carnegie-mellon-rocket-command/avionics-hw27-pelican/pelican.step

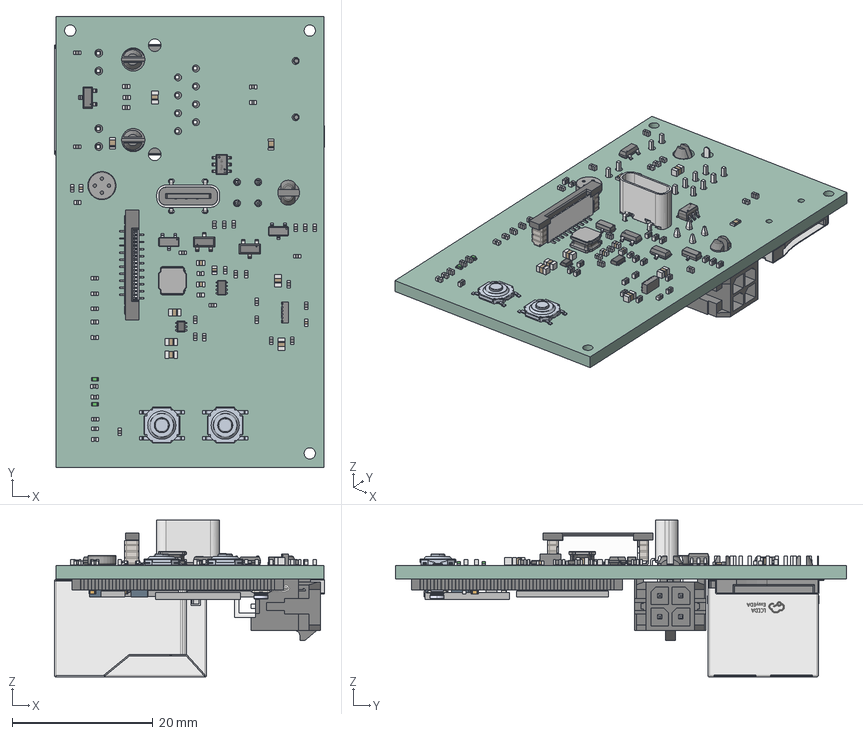
[picture p1: CAD file, 2026-10-25]
pelican.step
38.3 x 64.0 x 22.3 mm
IND-SMD_L4.0-W4.0-H1.9
RGT16
BODY-SOT x 2
CUI_CMC-4013-SMT
LED0402-RD_GREEN x 2
DMG2305UX-13 x 2
FPC-SMD_20P-P0.50_HDGC_0.5K-A-20PB
SOT-23-6_L2.9-W1.6-H1.5-LS2.8-P0.95
TYPE-C-SMD_USB4120-03-C
FRAME-DRL0006A
PIN1-ID
TF-SMD_TF-115-BCP9
OPEN_CASCADE_STEP_TRANSLATOR_7_
EXTRUDED-9461
USER_LIBRARY-U_FL-R-SMT_10_
USER_LIBRARY-0201_0603M__CAP_1 x 37
USER_LIBRARY-0201_0603M__CAP_2 x 37
USER_LIBRARY-0201_0603M__CAP_3 x 37
3_1_A x 32
SOD323
5_1_2_A x 11
_7_AF0 x 11
EXTRUDED-47948 x 3
USER_LIBRARY-RES_0603-0201_1 x 45
USER_LIBRARY-RES_0603-0201_2 x 45
USER_LIBRARY-RES_0603-0201_3 x 45
USER_LIBRARY-RES_0603-0201_4 x 45
EXTRUDED-53873
EXTRUDED-54088
EXTRUDED-54303
EXTRUDED-54518
EXTRUDED-54737
EXTRUDED-54962
RJ45-TH_HR911105A
pelican_PCB
