carnegie-mellon-rocket-command/avionics-hw27-pelican/pelican.kicad_pcb

## KiCad design pelican.kicad_pcb (2026-10-16)

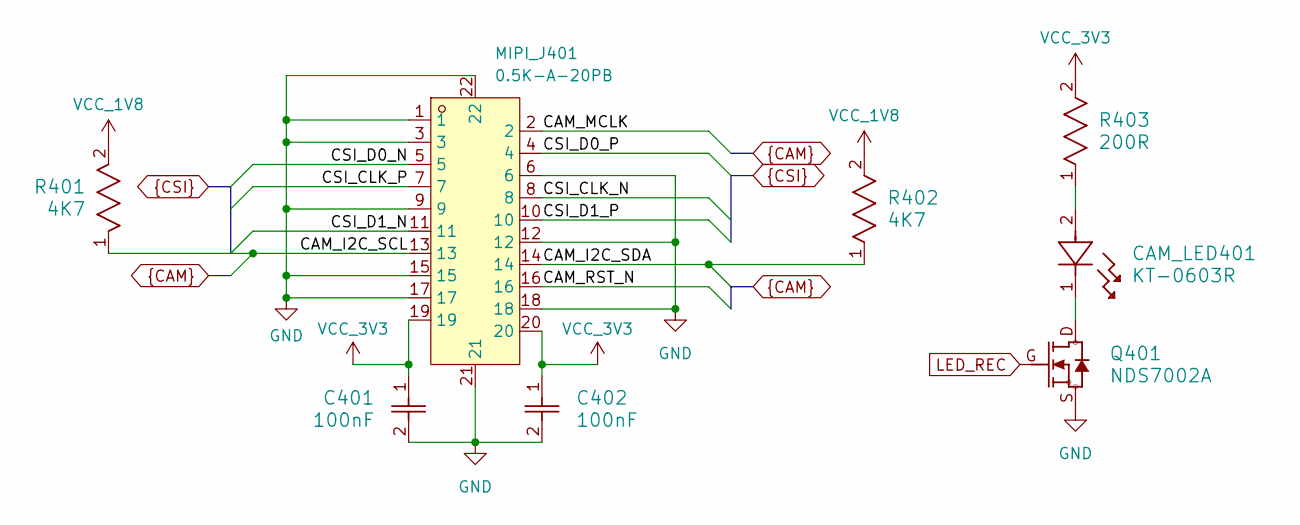
[picture p2: schematic camera_pelican.kicad_sch, Pelican]

Parts:
C401, C402: 100nF; C_GRM155R71C104KA88D; LCSC Part # C1525
CAM_LED401: KT-0603R; LED_LTST-C193KRKT-5A; LCSC Part # C2286
MIPI_J401: 0.5K-A-20PB; J_0.5K-A-20PB; MPN 0.5K-A-20PB; LCSC Part C2914144
Q401: NDS7002A; Q_NDS7002A; LCSC Part # C74715
R401, R402: 4K7; R_RC0402FR; LCSC Part # C25900
R403: 200R; R_RC0402FR; LCSC Part # C25087

Connections:
CAM_I2C_SCL: MIPI_J401.13, R401.1; also elsewhere on the board
CAM_I2C_SDA: MIPI_J401.14, R402.1; also elsewhere on the board
CAM_MCLK: MIPI_J401.2; also elsewhere on the board
CAM_RST_N: MIPI_J401.16; also elsewhere on the board
CSI_CLK_N: MIPI_J401.8; also elsewhere on the board
CSI_CLK_P: MIPI_J401.7; also elsewhere on the board
CSI_D0_N: MIPI_J401.5; also elsewhere on the board
CSI_D0_P: MIPI_J401.4; also elsewhere on the board
CSI_D1_N: MIPI_J401.11; also elsewhere on the board
CSI_D1_P: MIPI_J401.10; also elsewhere on the board
GND: C401.2, C402.2, MIPI_J401.1, MIPI_J401.3, MIPI_J401.6, MIPI_J401.9, MIPI_J401.12, MIPI_J401.15, MIPI_J401.17, MIPI_J401.18, MIPI_J401.21, MIPI_J401.22, Q401.S; also elsewhere on the board
LED_REC: Q401.G; also elsewhere on the board
unnamed: CAM_LED401.1, Q401.D
unnamed: CAM_LED401.2, R403.1
VCC_1V8: R401.2, R402.2; also elsewhere on the board
VCC_3V3: C401.1, C402.1, MIPI_J401.19, MIPI_J401.20, R403.2; also elsewhere on the board

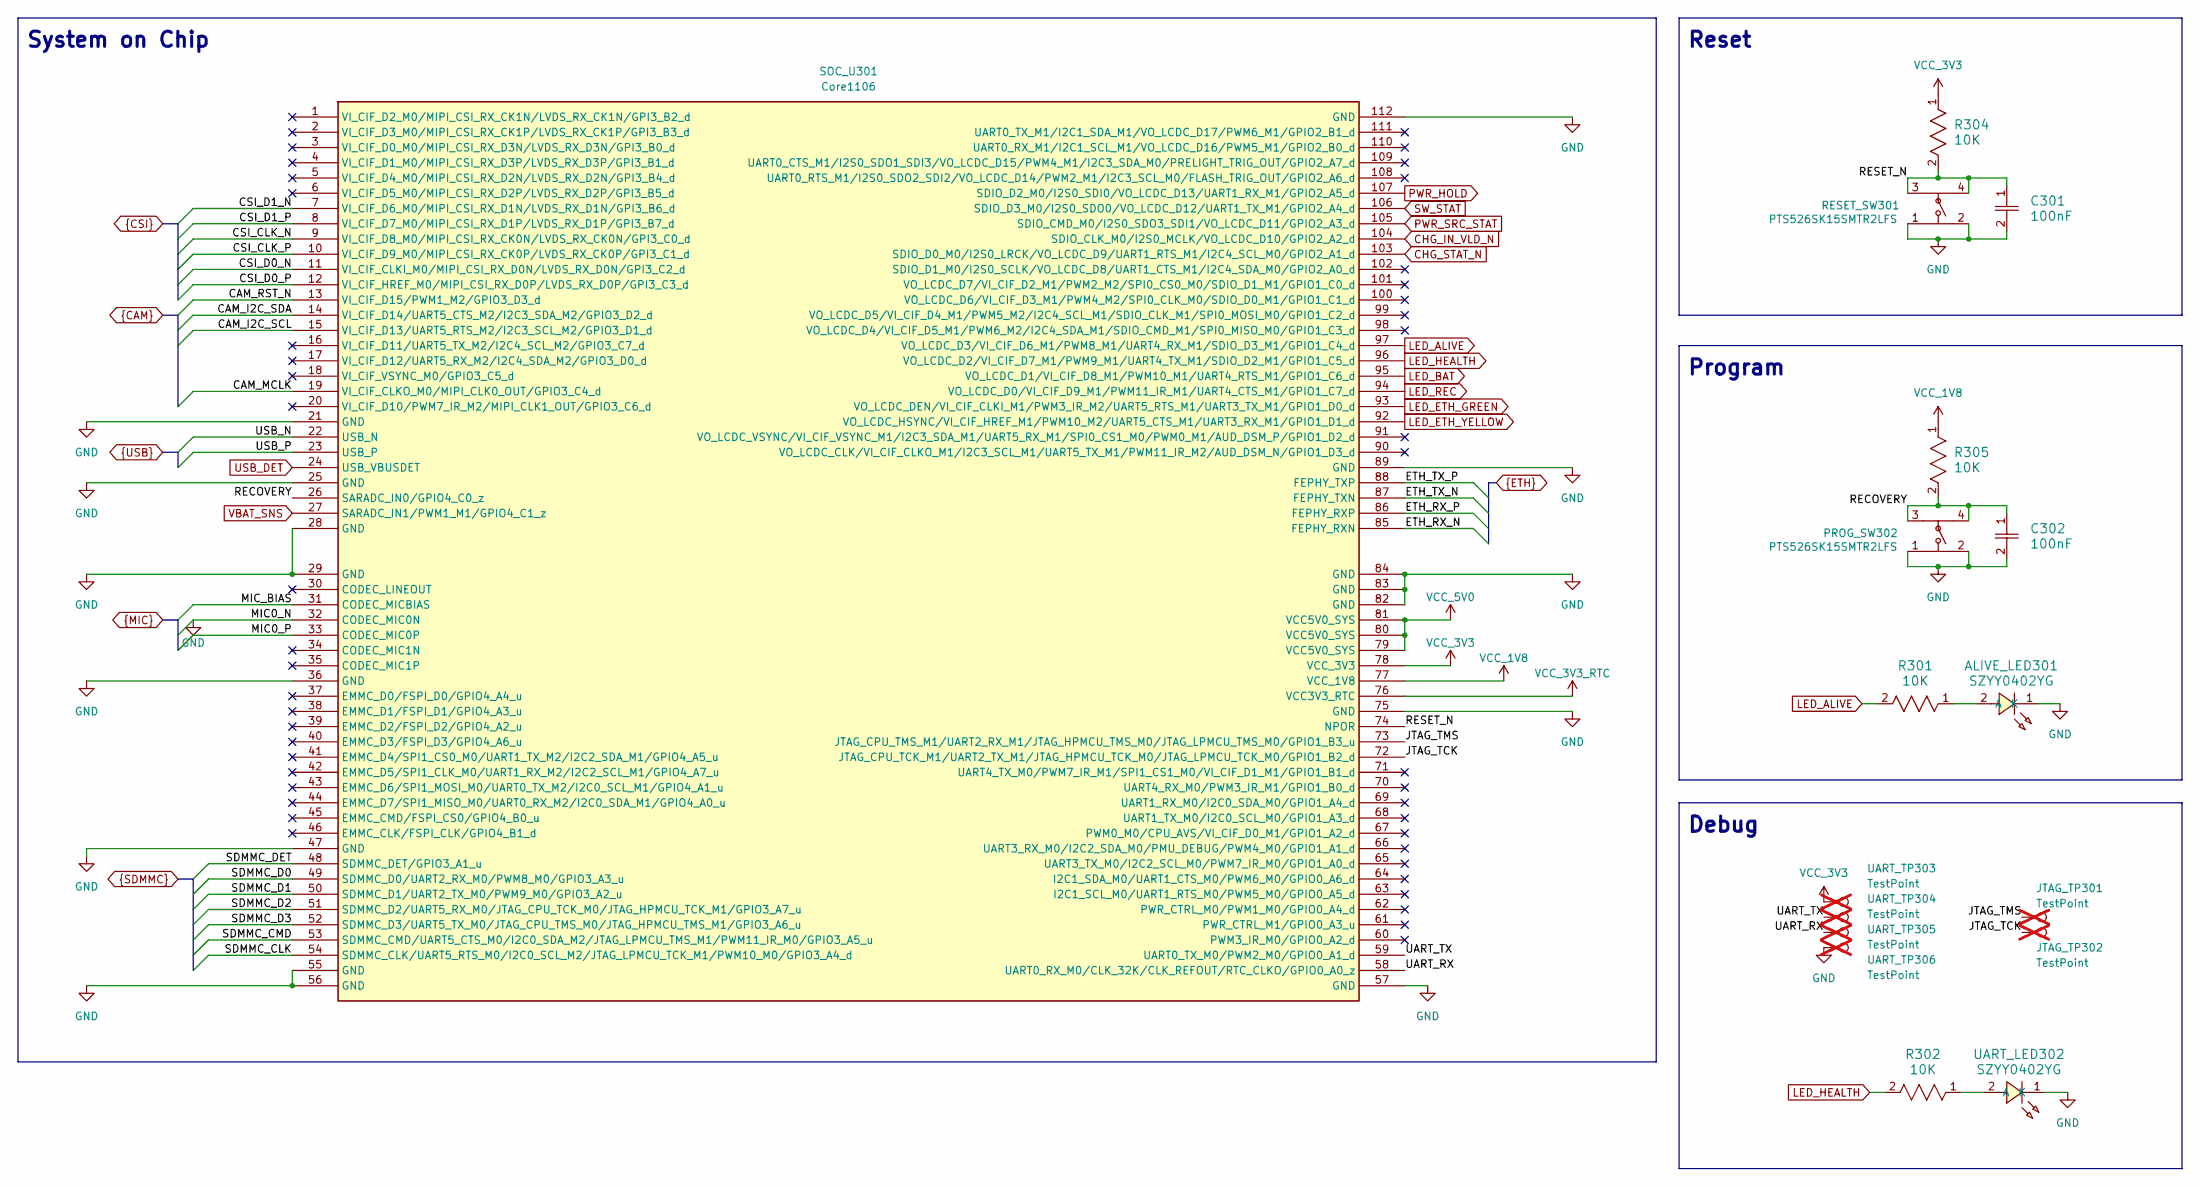
[picture p3: schematic core_pelican.kicad_sch, Pelican]

Parts:
ALIVE_LED301: SZYY0402YG; LED_SZYY0402YG; MPN SZYY0402YG; LCSC Part # C434449
C301, C302: 100nF; C_GRM155R71C104KA88D; LCSC Part # C1525
JTAG_TP301, JTAG_TP302: TestPoint; TestPoint_Pad_D1.5mm; not fitted
PROG_SW302: PTS526SK15SMTR2LFS; SW_PTS526SK15SMTR2LFS; LCSC Part # C2689521
R301, R302, R304, R305: 10K; R_RC0402FR; LCSC Part # C25744
RESET_SW301: PTS526SK15SMTR2LFS; SW_PTS526SK15SMTR2LFS; LCSC Part # C2689521
SOC_U301: Core1106; P_Core1106
UART_LED302: SZYY0402YG; LED_SZYY0402YG; MPN SZYY0402YG; LCSC Part # C434449
UART_TP303, UART_TP304, UART_TP305, UART_TP306: TestPoint; TestPoint_Pad_D1.5mm; not fitted

Connections:
/Core/JTAG_TCK: JTAG_TP302.1 (1_1), SOC_U301.72 (JTAG_CPU_TCK_M1/UART2_TX_M1/JTAG_HPMCU_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)
/Core/JTAG_TMS: JTAG_TP301.1 (1_1), SOC_U301.73 (JTAG_CPU_TMS_M1/UART2_RX_M1/JTAG_HPMCU_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)
/Core/RECOVERY: C302.1, PROG_SW302.3, PROG_SW302.4, R305.2, SOC_U301.26 (SARADC_IN0/GPIO4_C0_z)
/Core/RESET_N: C301.1, R304.2, RESET_SW301.3, RESET_SW301.4, SOC_U301.74 (NPOR)
/Core/UART_RX: SOC_U301.58 (UART0_RX_M0/CLK_32K/CLK_REFOUT/RTC_CLKO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), UART_TP305.1 (1_1)
/Core/UART_TX: SOC_U301.59 (UART0_TX_M0/PWM2_M0/GPIO0_A1_d), UART_TP304.1 (1_1)
CAM_I2C_SCL: SOC_U301.15 (VI_CIF_D13/UART5_RTS_M2/I2C3_SCL_M2/GPI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); also elsewhere on the board
CAM_I2C_SDA: SOC_U301.14 (VI_CIF_D14/UART5_CTS_M2/I2C3_SDA_M2/GPI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); also elsewhere on the board
CAM_MCLK: SOC_U301.19 (VI_CIF_CLKO_M0/MIPI_CLK0_OUT/GPIO3_C4_d); also elsewhere on the board
CAM_RST_N: SOC_U301.13 (VI_CIF_D15/PWM1_M2/GPIO3_D3_d); also elsewhere on the board
CHG_IN_VLD_N: SOC_U301.104 (SDIO_CLK_M0/I2S0_MCLK/VO_LCDC_D10/GPIO2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); also elsewhere on the board
CHG_STAT_N: SOC_U301.103 (SDIO_D0_M0/I2S0_LRCK/VO_LCDC_D9/UART1_R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); also elsewhere on the board
CSI_CLK_N: SOC_U301.9 (VI_CIF_D8_M0/MIPI_CSI_RX_CK0N/LVDS_RX_C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); also elsewhere on the board
CSI_CLK_P: SOC_U301.10 (VI_CIF_D9_M0/MIPI_CSI_RX_CK0P/LVDS_RX_C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); also elsewhere on the board
CSI_D0_N: SOC_U301.11 (VI_CIF_CLKI_M0/MIPI_CSI_RX_D0N/LVDS_RX_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); also elsewhere on the board
CSI_D0_P: SOC_U301.12 (VI_CIF_HREF_M0/MIPI_CSI_RX_D0P/LVDS_RX_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); also elsewhere on the board
CSI_D1_N: SOC_U301.7 (VI_CIF_D6_M0/MIPI_CSI_RX_D1N/LVDS_RX_D1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); also elsewhere on the board
CSI_D1_P: SOC_U301.8 (VI_CIF_D7_M0/MIPI_CSI_RX_D1P/LVDS_RX_D1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); also elsewhere on the board
ETH_RX_N: SOC_U301.85 (FEPHY_RXN); also elsewhere on the board
ETH_RX_P: SOC_U301.86 (FEPHY_RXP); also elsewhere on the board
ETH_TX_N: SOC_U301.87 (FEPHY_TXN); also elsewhere on the board
ETH_TX_P: SOC_U301.88 (FEPHY_TXP); also elsewhere on the board
GND: ALIVE_LED301.1 (K), C301.2, C302.2, PROG_SW302.1, PROG_SW302.2, RESET_SW301.1, RESET_SW301.2, SOC_U301.21 (GND), SOC_U301.25 (GND), SOC_U301.28 (GND), SOC_U301.29 (GND), SOC_U301.32 (CODEC_MIC0N), SOC_U301.36 (GND), SOC_U301.47 (GND), SOC_U301.55 (GND), SOC_U301.56 (GND), SOC_U301.57 (GND), SOC_U301.75 (GND), SOC_U301.82 (GND), SOC_U301.83 (GND), SOC_U301.84 (GND), SOC_U301.89 (GND), SOC_U301.112 (GND), UART_LED302.1 (K), UART_TP306.1 (1_1); also elsewhere on the board
LED_ALIVE: R301.2, SOC_U301.97 (VO_LCDC_D3/VI_CIF_D6_M1/PWM8_M1/UART4_R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)
LED_BAT: SOC_U301.95 (VO_LCDC_D1/VI_CIF_D8_M1/PWM10_M1/UART4_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); also elsewhere on the board
LED_ETH_GREEN: SOC_U301.93 (VO_LCDC_DEN/VI_CIF_CLKI_M1/PWM3_IR_M2/U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); also elsewhere on the board
LED_ETH_YELLOW: SOC_U301.92 (VO_LCDC_HSYNC/VI_CIF_HREF_M1/PWM10_M2/U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); also elsewhere on the board
LED_HEALTH: R302.2, SOC_U301.96 (VO_LCDC_D2/VI_CIF_D7_M1/PWM9_M1/UART4_T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)
LED_REC: SOC_U301.94 (VO_LCDC_D0/VI_CIF_D9_M1/PWM11_IR_M1/UAR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); also elsewhere on the board
MIC0_P: SOC_U301.33 (CODEC_MIC0P); also elsewhere on the board
MIC_BIAS: SOC_U301.31 (CODEC_MICBIAS); also elsewhere on the board
unnamed: ALIVE_LED301.2 (A), R301.1
unnamed: R302.1, UART_LED302.2 (A)
PWR_HOLD: SOC_U301.107 (SDIO_D2_M0/I2S0_SDI0/VO_LCDC_D13/UART1_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); also elsewhere on the board
PWR_SRC_STAT: SOC_U301.105 (SDIO_CMD_M0/I2S0_SDO3_SDI1/VO_LCDC_D11/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); also elsewhere on the board
SDMMC_CLK: SOC_U301.54 (SDMMC_CLK/UART5_RTS_M0/I2C0_SCL_M2/JTAG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); also elsewhere on the board
SDMMC_CMD: SOC_U301.53 (SDMMC_CMD/UART5_CTS_M0/I2C0_SDA_M2/JTAG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); also elsewhere on the board
SDMMC_D0: SOC_U301.49 (SDMMC_D0/UART2_RX_M0/PWM8_M0/GPIO3_A3_u); also elsewhere on the board
SDMMC_D1: SOC_U301.50 (SDMMC_D1/UART2_TX_M0/PWM9_M0/GPIO3_A2_u); also elsewhere on the board
SDMMC_D2: SOC_U301.51 (SDMMC_D2/UART5_RX_M0/JTAG_CPU_TCK_M0/JT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); also elsewhere on the board
SDMMC_D3: SOC_U301.52 (SDMMC_D3/UART5_TX_M0/JTAG_CPU_TMS_M0/JT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); also elsewhere on the board
SDMMC_DET: SOC_U301.48 (SDMMC_DET/GPIO3_A1_u); also elsewhere on the board
SW_STAT: SOC_U301.106 (SDIO_D3_M0/I2S0_SDO0/VO_LCDC_D12/UART1_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); also elsewhere on the board
USB_DET: SOC_U301.24 (USB_VBUSDET); also elsewhere on the board
USB_N: SOC_U301.22 (USB_N); also elsewhere on the board
USB_P: SOC_U301.23 (USB_P); also elsewhere on the board
VBAT_SNS: SOC_U301.27 (SARADC_IN1/PWM1_M1/GPIO4_C1_z); also elsewhere on the board
VCC_1V8: R305.1, SOC_U301.77 (VCC_1V8); also elsewhere on the board
VCC_3V3: R304.1, SOC_U301.78 (VCC_3V3), UART_TP303.1 (1_1); also elsewhere on the board
VCC_3V3_RTC: SOC_U301.76 (VCC3V3_RTC)
VCC_5V0: SOC_U301.79 (VCC5V0_SYS), SOC_U301.80 (VCC5V0_SYS), SOC_U301.81 (VCC5V0_SYS); also elsewhere on the board

Notes on the sheet:
Debug
System on Chip
Program
Reset

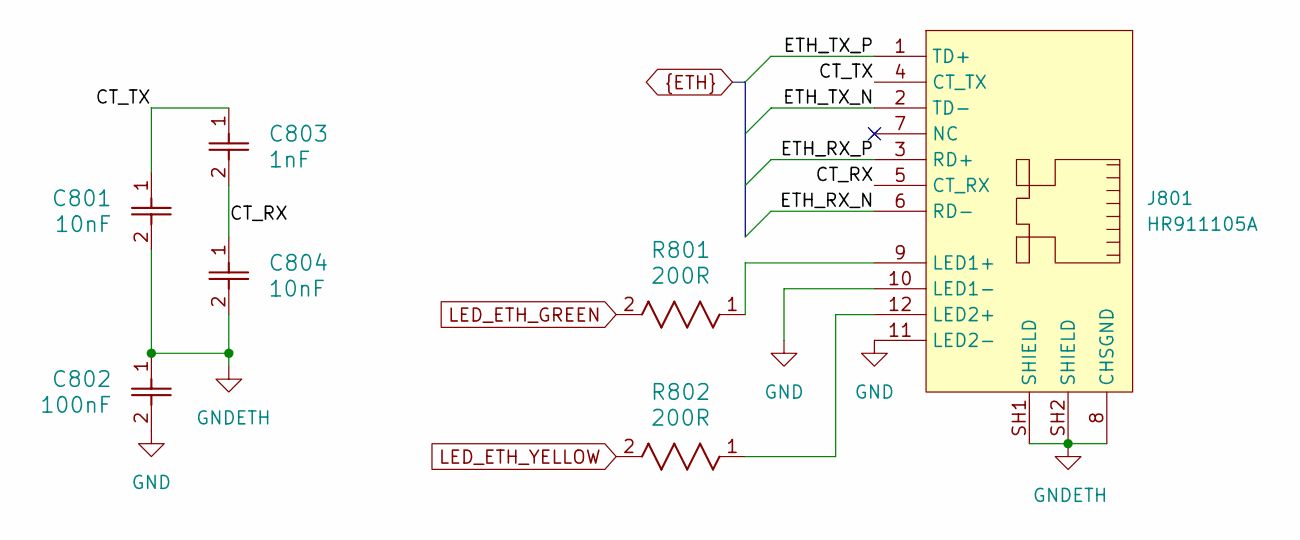
[picture p4: schematic ethernet_pelican.kicad_sch, Pelican]

Parts:
C801, C804: 10nF; C_CL05B103KO5NNNC; MPN CL05B103KO5NNNC; LCSC Part # C15195
C802: 100nF; C_GRM155R71C104KA88D; LCSC Part # C1525
C803: 1nF; C_CC0603CG100V102JN; MPN CC0603CG100V102JN; LCSC Part # C53084479
J801: HR911105A; J_HR911105A_TH; MPN HR911105A; LCSC Part C12074
R801, R802: 200R; R_RC0402FR; LCSC Part # C25087

Connections:
/Ethernet/CT_RX: C803.2, C804.1, J801.5 (CT_RX)
/Ethernet/CT_TX: C801.1, C803.1, J801.4 (CT_TX)
ETH_RX_N: J801.6 (RD-); also elsewhere on the board
ETH_RX_P: J801.3 (RD+); also elsewhere on the board
ETH_TX_N: J801.2 (TD-); also elsewhere on the board
ETH_TX_P: J801.1 (TD+); also elsewhere on the board
GND: C802.2, J801.10 (LED1-), J801.11 (LED2-); also elsewhere on the board
GNDETH: C801.2, C802.1, C804.2, J801.8 (CHSGND), J801.SH1 (SHIELD), J801.SH2 (SHIELD)
LED_ETH_GREEN: R801.2; also elsewhere on the board
LED_ETH_YELLOW: R802.2; also elsewhere on the board
unnamed: J801.9 (LED1+), R801.1
unnamed: J801.12 (LED2+), R802.1

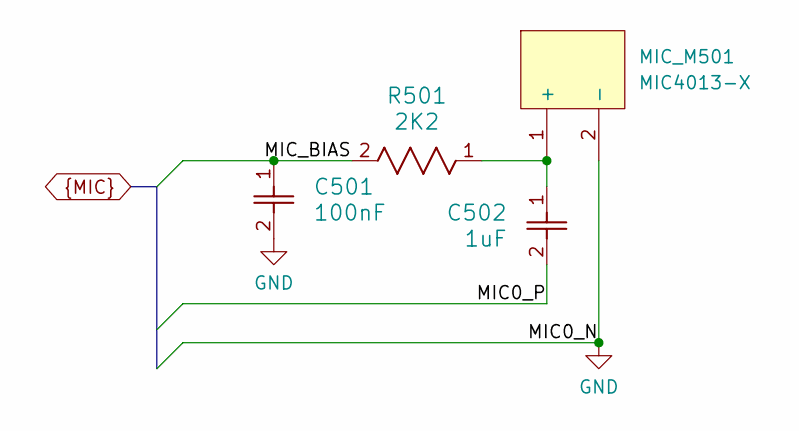
[picture p5: schematic microphone_pelican.kicad_sch, Pelican]

Parts:
C501: 100nF; C_GRM155R71C104KA88D; LCSC Part # C1525
C502: 1uF; C_GRM155R61A105KE15D; LCSC Part # C52923
MIC_M501: MIC4013-X; M_MIC4013-X; MPN MIC4013-X; LCSC Part # C49118137
R501: 2K2; R_RC0402FR; LCSC Part # C25879

Connections:
GND: C501.2, MIC_M501.2 (-); also elsewhere on the board
MIC0_P: C502.2; also elsewhere on the board
MIC_BIAS: C501.1, R501.2; also elsewhere on the board
unnamed: C502.1, MIC_M501.1 (+), R501.1

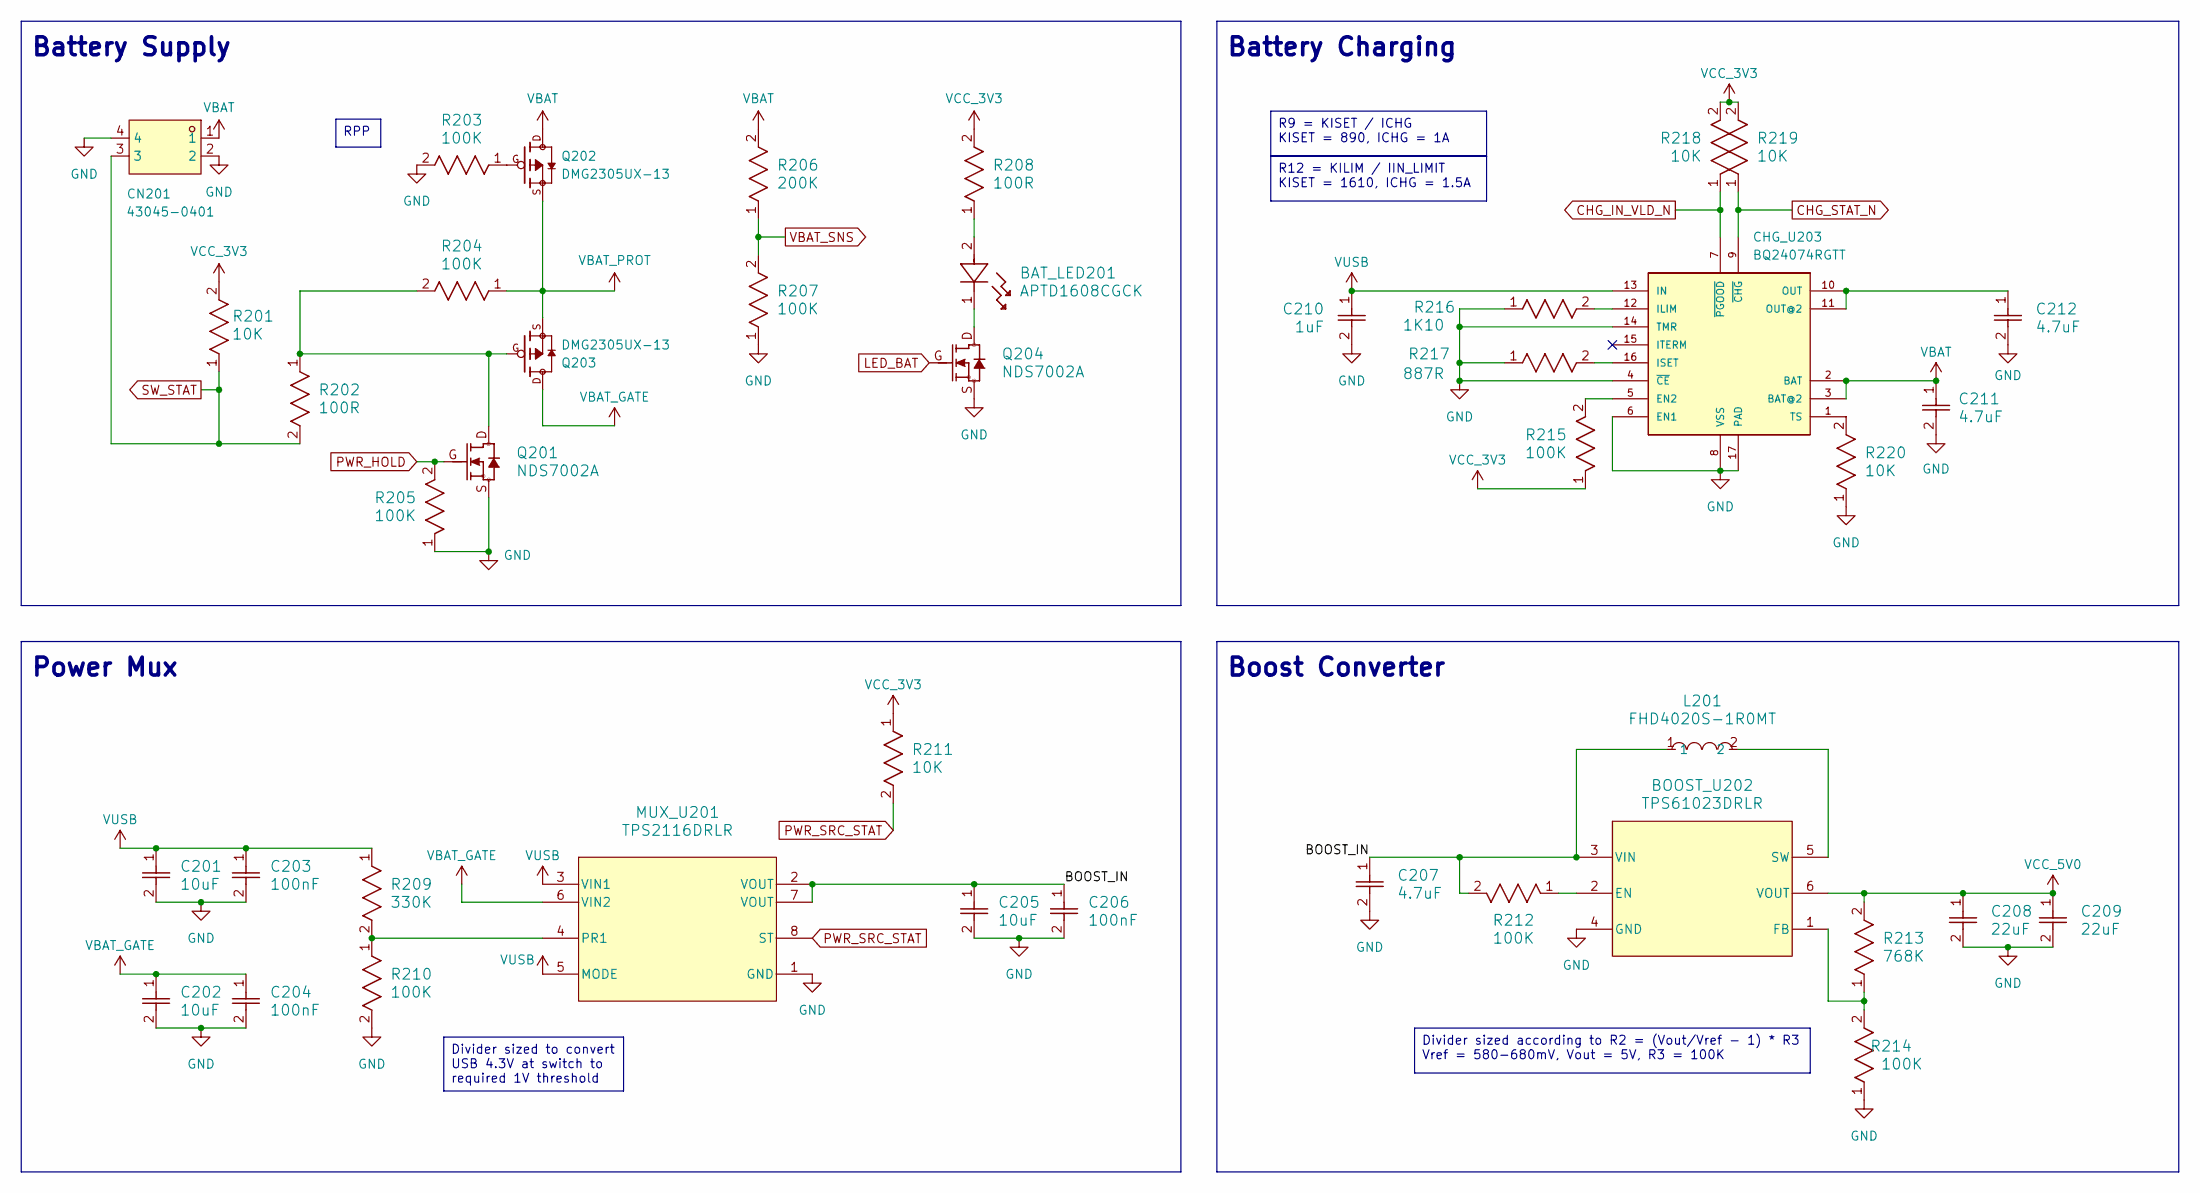
[picture p6: schematic power_pelican.kicad_sch, Pelican]

Parts:
BAT_LED201: APTD1608CGCK; LED_LTST-C193KGKT-5A; LCSC Part # C5121471
BOOST_U202: TPS61023DRLR; U_TPS61023DRLR; LCSC Part # C919459
C201, C202, C205: 10uF; C_GRM155R61A106ME11D; LCSC Part # C408132
C203, C204, C206: 100nF; C_GRM155R71C104KA88D; LCSC Part # C1525
C207, C211, C212: 4.7uF; C_GRM188R61A475KE15D; LCSC Part # C19666
C208, C209: 22uF; C_GRM188R61A226ME15D; LCSC Part # C84419
C210: 1uF; C_GRM155R61A105KE15D; LCSC Part # C52923
CHG_U203: BQ24074RGTT; U_BQ24074RGTT; LCSC Part # C2861252
CN201: 43045-0401; J_43045-0401_2x02_RA; MPN 430450401; LCSC Part C585880
L201: FHD4020S-1R0MT; L_FHD4020S-1R0MT; MPN FHD4020S-1R0MT; LCSC Part # C602028
MUX_U201: TPS2116DRLR; U_TPS2116DRLR; LCSC Part # C3235557
Q201, Q204: NDS7002A; Q_NDS7002A; LCSC Part # C74715
Q202, Q203: DMG2305UX-13; Q_DMG2305UX-13; PARTREV 09/2018; LCSC Part # C144153
R201, R211, R218, R219, R220: 10K; R_RC0402FR; LCSC Part # C25744
R202, R208: 100R; R_RC0402FR; LCSC Part # C25076
R203, R204, R205, R207, R210, R212, R214, R215: 100K; R_RC0402FR; LCSC Part # C25741
R206: 200K; R_RC0402FR; LCSC Part # C25764
R209: 330K; R_RC0402FR; LCSC Part # C25778
R213: 768K; R_RC0402FR; LCSC Part # C273722
R216: 1K10; R_RC0402FR; LCSC Part # C25860
R217: 887R; R_RC0402FR; LCSC Part # C477810

Connections:
/Power/BOOST_IN: BOOST_U202.3 (VIN), C205.1, C206.1, C207.1, L201.1, MUX_U201.2 (VOUT), MUX_U201.7 (VOUT), R212.2
CHG_IN_VLD_N: CHG_U203.7 (~PGOOD), R218.1; also elsewhere on the board
CHG_STAT_N: CHG_U203.9 (~CHG), R219.1; also elsewhere on the board
GND: BOOST_U202.4 (GND), C201.2, C202.2, C203.2, C204.2, C205.2, C206.2, C207.2, C208.2, C209.2, C210.2, C211.2, C212.2, CHG_U203.4 (~CE), CHG_U203.6 (EN1), CHG_U203.8 (VSS), CHG_U203.14 (TMR), CHG_U203.17 (PAD), CN201.2, CN201.4, MUX_U201.1 (GND), Q201.S, Q204.S, R203.2, R205.1, R207.1, R210.2, R214.1, R216.1, R217.1, R220.1; also elsewhere on the board
LED_BAT: Q204.G; also elsewhere on the board
unnamed: BAT_LED201.1, Q204.D
unnamed: BAT_LED201.2, R208.1
unnamed: BOOST_U202.2 (EN), R212.1
unnamed: BOOST_U202.1 (FB), R213.1, R214.2
unnamed: BOOST_U202.5 (SW), L201.2
unnamed: CHG_U203.5 (EN2), R215.2
unnamed: CHG_U203.12 (ILIM), R216.2
unnamed: CHG_U203.16 (ISET), R217.2
unnamed: C212.1, CHG_U203.10 (OUT), CHG_U203.11 (OUT@2)
unnamed: CHG_U203.1 (TS), R220.2
unnamed: MUX_U201.4 (PR1), R209.2, R210.1
unnamed: Q201.D, Q203.G, R202.1, R204.2
unnamed: Q202.G, R203.1
unnamed: Q202.S, Q203.S, R204.1
PWR_HOLD: Q201.G, R205.2; also elsewhere on the board
PWR_SRC_STAT: MUX_U201.8 (ST), R211.2; also elsewhere on the board
SW_STAT: CN201.3, R201.1, R202.2; also elsewhere on the board
VBAT: C211.1, CHG_U203.2 (BAT), CHG_U203.3 (BAT@2), CN201.1, Q202.D, R206.2
VBAT_GATE: C202.1, C204.1, MUX_U201.6 (VIN2), Q203.D
VBAT_SNS: R206.1, R207.2; also elsewhere on the board
VCC_3V3: R201.2, R208.2, R211.1, R215.1, R218.2, R219.2; also elsewhere on the board
VCC_5V0: BOOST_U202.6 (VOUT), C208.1, C209.1, R213.2; also elsewhere on the board
VUSB: C201.1, C203.1, C210.1, CHG_U203.13 (IN), MUX_U201.3 (VIN1), MUX_U201.5 (MODE), R209.1; also elsewhere on the board

Notes on the sheet:
Battery Charging
Power Mux
Battery Supply
Boost Converter
Divider sized according to R2 = (Vout/Vref - 1) * R3 Vref = 580-680mV, Vout = 5V, R3 = 100K
R12 = KILIM / IIN_LIMIT KISET = 1610, ICHG = 1.5A
R9 = KISET / ICHG KISET = 890, ICHG = 1A
Divider sized to convert USB 4.3V at switch to required 1V threshold
RPP

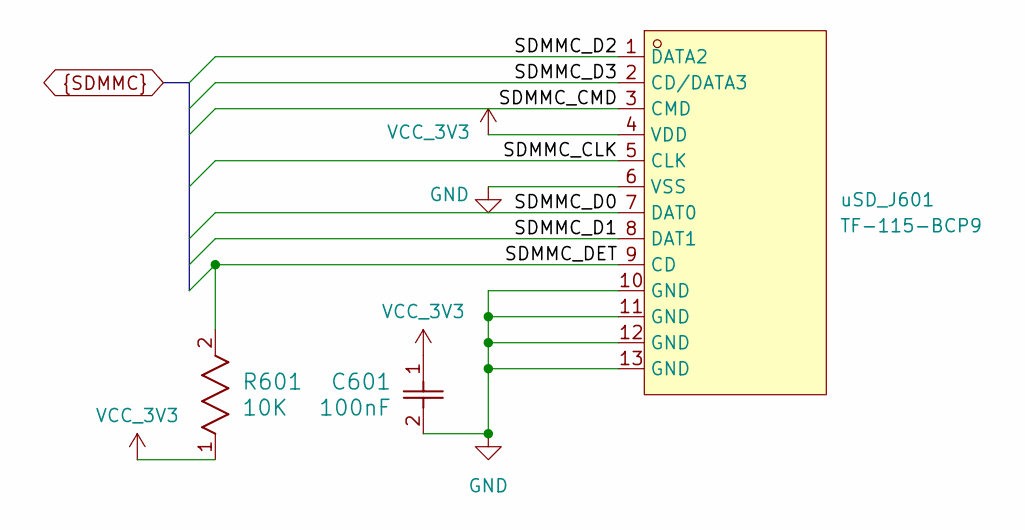
[picture p7: schematic storage_pelican.kicad_sch, Pelican]

Parts:
C601: 100nF; C_GRM155R71C104KA88D; LCSC Part # C1525
R601: 10K; R_RC0402FR; LCSC Part # C25744
uSD_J601: TF-115-BCP9; J_TF-115-BCP9; MPN TF-115-BCP9; LCSC Part # C720505

Connections:
GND: C601.2, uSD_J601.6 (VSS), uSD_J601.10 (GND), uSD_J601.11 (GND), uSD_J601.12 (GND), uSD_J601.13 (GND); also elsewhere on the board
SDMMC_CLK: uSD_J601.5 (CLK); also elsewhere on the board
SDMMC_CMD: uSD_J601.3 (CMD); also elsewhere on the board
SDMMC_D0: uSD_J601.7 (DAT0); also elsewhere on the board
SDMMC_D1: uSD_J601.8 (DAT1); also elsewhere on the board
SDMMC_D2: uSD_J601.1 (DATA2); also elsewhere on the board
SDMMC_D3: uSD_J601.2 (CD/DATA3); also elsewhere on the board
SDMMC_DET: R601.2, uSD_J601.9 (CD); also elsewhere on the board
VCC_3V3: C601.1, R601.1, uSD_J601.4 (VDD); also elsewhere on the board

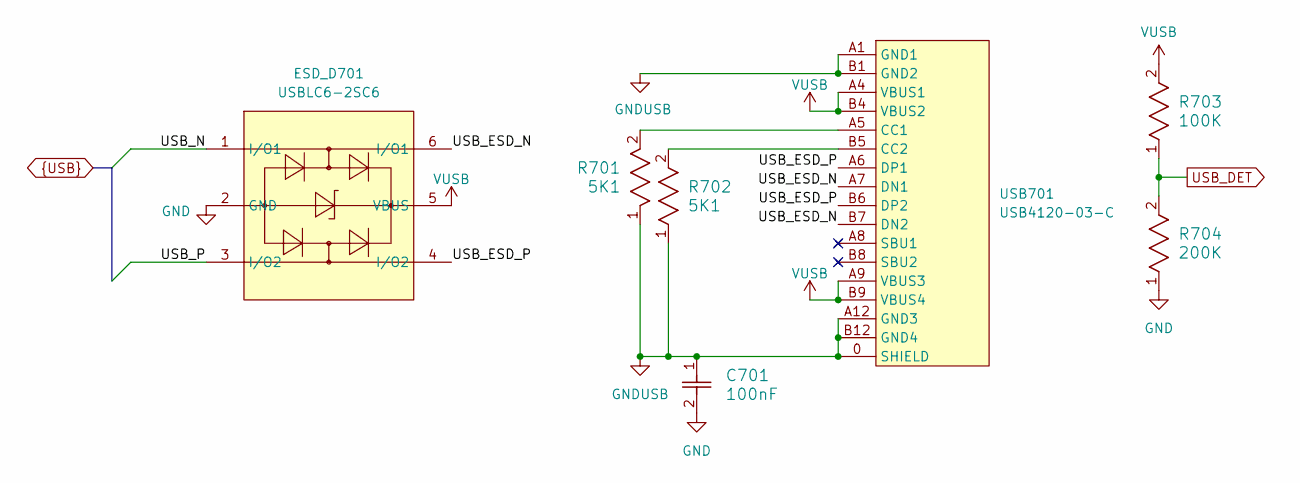
[picture p8: schematic usb_pelican.kicad_sch, Pelican]

Parts:
C701: 100nF; C_GRM155R71C104KA88D; LCSC Part # C1525
ESD_D701: USBLC6-2SC6; D_USBLC6-2SC6; MPN USBLC6-2SC6; LCSC Part # C7519
R701, R702: 5K1; R_RC0402FR; LCSC Part # C25905
R703: 100K; R_RC0402FR; LCSC Part # C25741
R704: 200K; R_RC0402FR; LCSC Part # C25764
USB701: USB4120-03-C; J_USB4120-03-C_SMD; MPN USB4120-03-C; LCSC Part C3445864

Connections:
/USB/USB_ESD_N: ESD_D701.6 (I/O1), USB701.A7 (DN1), USB701.B7 (DN2)
/USB/USB_ESD_P: ESD_D701.4 (I/O2), USB701.A6 (DP1), USB701.B6 (DP2)
GND: C701.2, ESD_D701.2 (GND), R704.1; also elsewhere on the board
GNDUSB: C701.1, R701.1, R702.1, USB701.0 (SHIELD), USB701.A1 (GND1), USB701.A12 (GND3), USB701.B1 (GND2), USB701.B12 (GND4)
unnamed: R701.2, USB701.A5 (CC1)
unnamed: R702.2, USB701.B5 (CC2)
USB_DET: R703.1, R704.2; also elsewhere on the board
USB_N: ESD_D701.1 (I/O1); also elsewhere on the board
USB_P: ESD_D701.3 (I/O2); also elsewhere on the board
VUSB: ESD_D701.5 (VBUS), R703.2, USB701.A4 (VBUS1), USB701.A9 (VBUS3), USB701.B4 (VBUS2), USB701.B9 (VBUS4); also elsewhere on the board

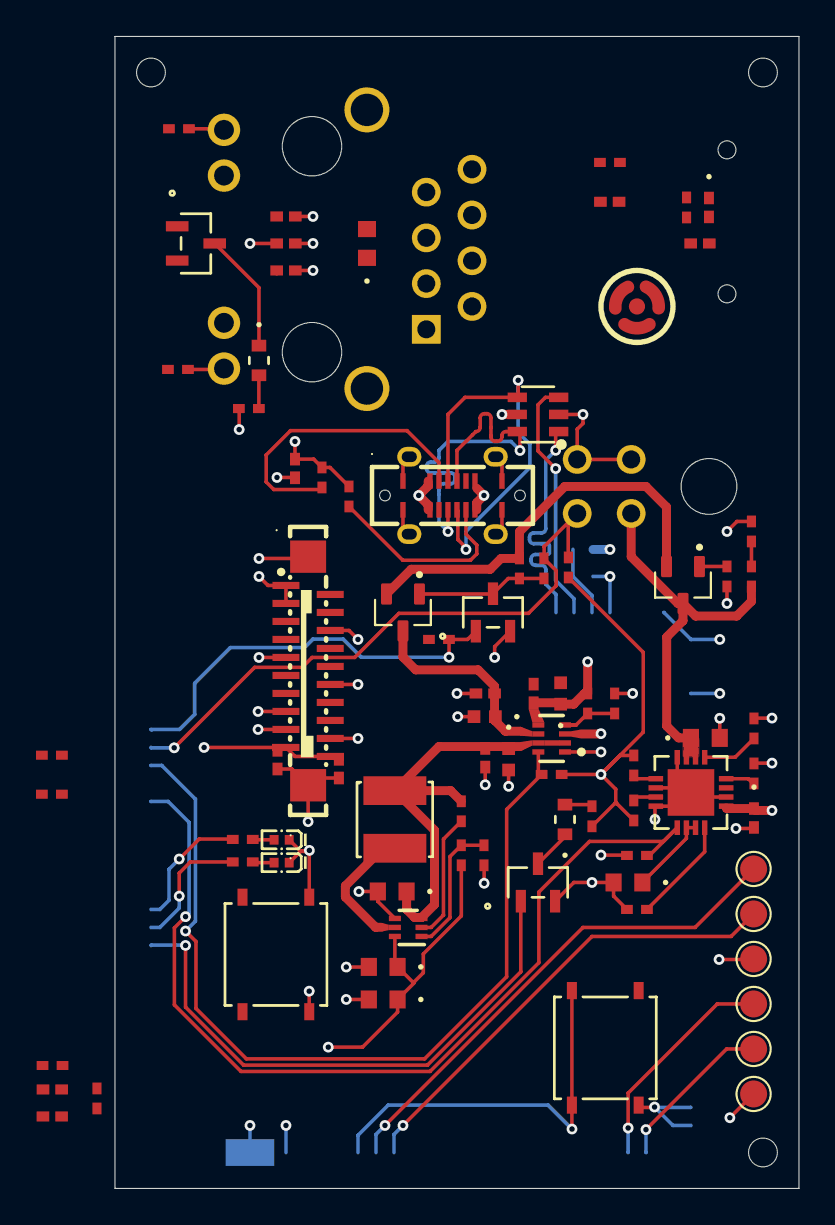
[picture p9: board pelican.kicad_pcb from above]

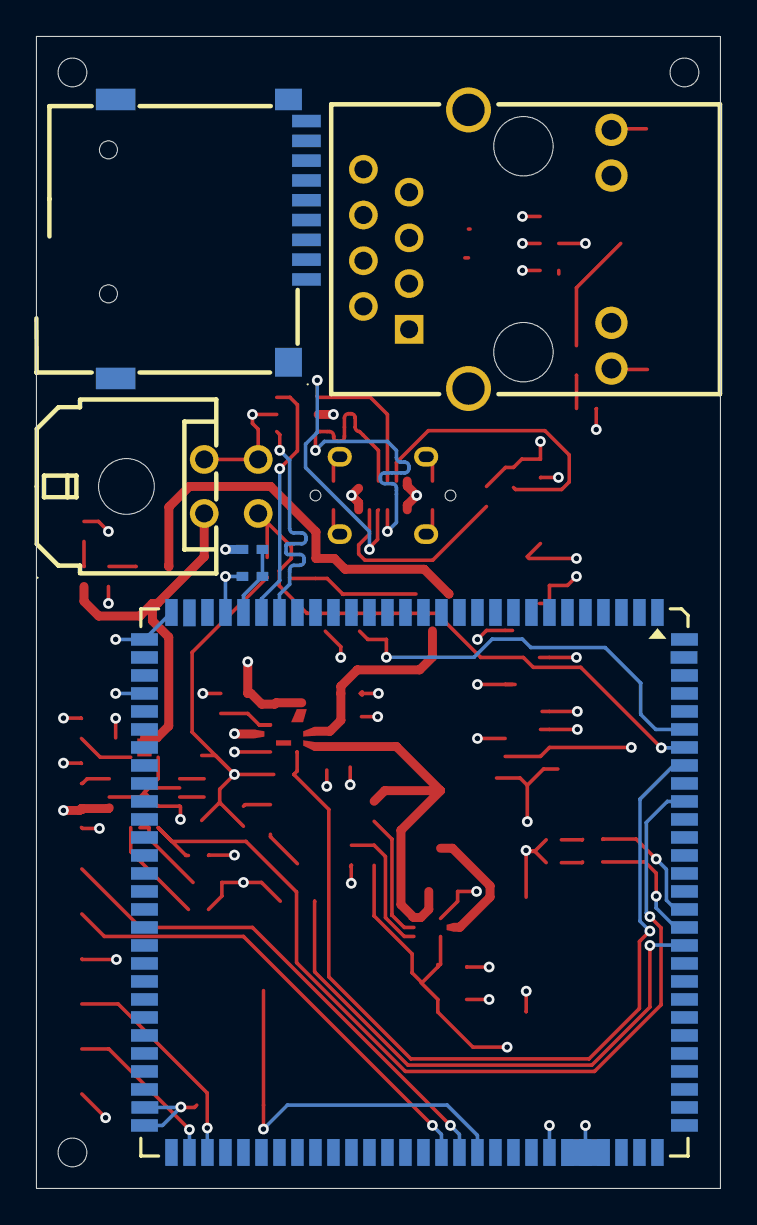
[picture p10: board pelican.kicad_pcb from below]

Board: 4 copper layers, 38.0 x 64.0 mm, 88 parts (6 on the bottom side), 81 nets.
