carnegie-mellon-rocket-command/avionics-hw27-pelican/(commit log)

2026-09-18 Pre-layout schematic cleanup: net-naming pass + clear all ERC errors
    Net naming (role-token scheme): BAT_V_STAT->VBAT_SNS,
    BAT_CHG_STAT->CHG_STAT_N, BAT_CHG_SRC_STAT->CHG_IN_VLD_N,
    HOLD_PWR->PWR_HOLD, CAM_RESET->CAM_RST_N (bus alias updated), and the
    PWR_SRC->PWR_SRC_STAT mux-status fix. Plus in-progress storage/ethernet/
    usb sheet edits and removal of the stale exported PDF.
    ERC error fixes (9 -> 0):
    - PWR_FLAG on the four undriven power nets (GND, GNDUSB, GNDETH,
    VBAT_GATE); PWR_FLAG added to the project power symbol library
    - Ground SoC codec pin 32 (CODEC_MIC0N); MIC0_N kept as a GND alias
    - Redundant paralleled power pins modeled as passive so ERC no longer
    reports power-output con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
    [camera_pelican.kicad_sch, core_pelican.kicad_sch, ethernet_pelican.kicad_sch, power_pelican.kicad_sch, storage_pelican.kicad_sch, usb_pelican.kicad_sch]
2026-09-27 pushed place
    [camera_pelican.kicad_sch, core_pelican.kicad_sch, ethernet_pelican.kicad_sch, microphone_pelican.kicad_sch, pelican.kicad_pcb, power_pelican.kicad_sch, storage_pelican.kicad_sch, usb_pelican.kicad_sch]
2026-10-16 pushed pcb routing
    [pelican.kicad_pcb]
